letmegobacktosleep/8k_hall_effect_keypad/README.md

8 key hall effect pcb using STM32F072CBT6
- has not been tested
- requires [JLCPCB Tools](https://github.com/Bouni/kicad-jlcpcb-tools) plugin for exporting gerbers/bom/pos

untested firmware available at https://github.com/letmegobacktosleep/qmk_firmware/tree/minipad
