letmegobacktosleep/8k_hall_effect_keypad/8 key thingy.kicad_pcb

## KiCad design 8 key thingy.kicad_pcb (2024-04-30)

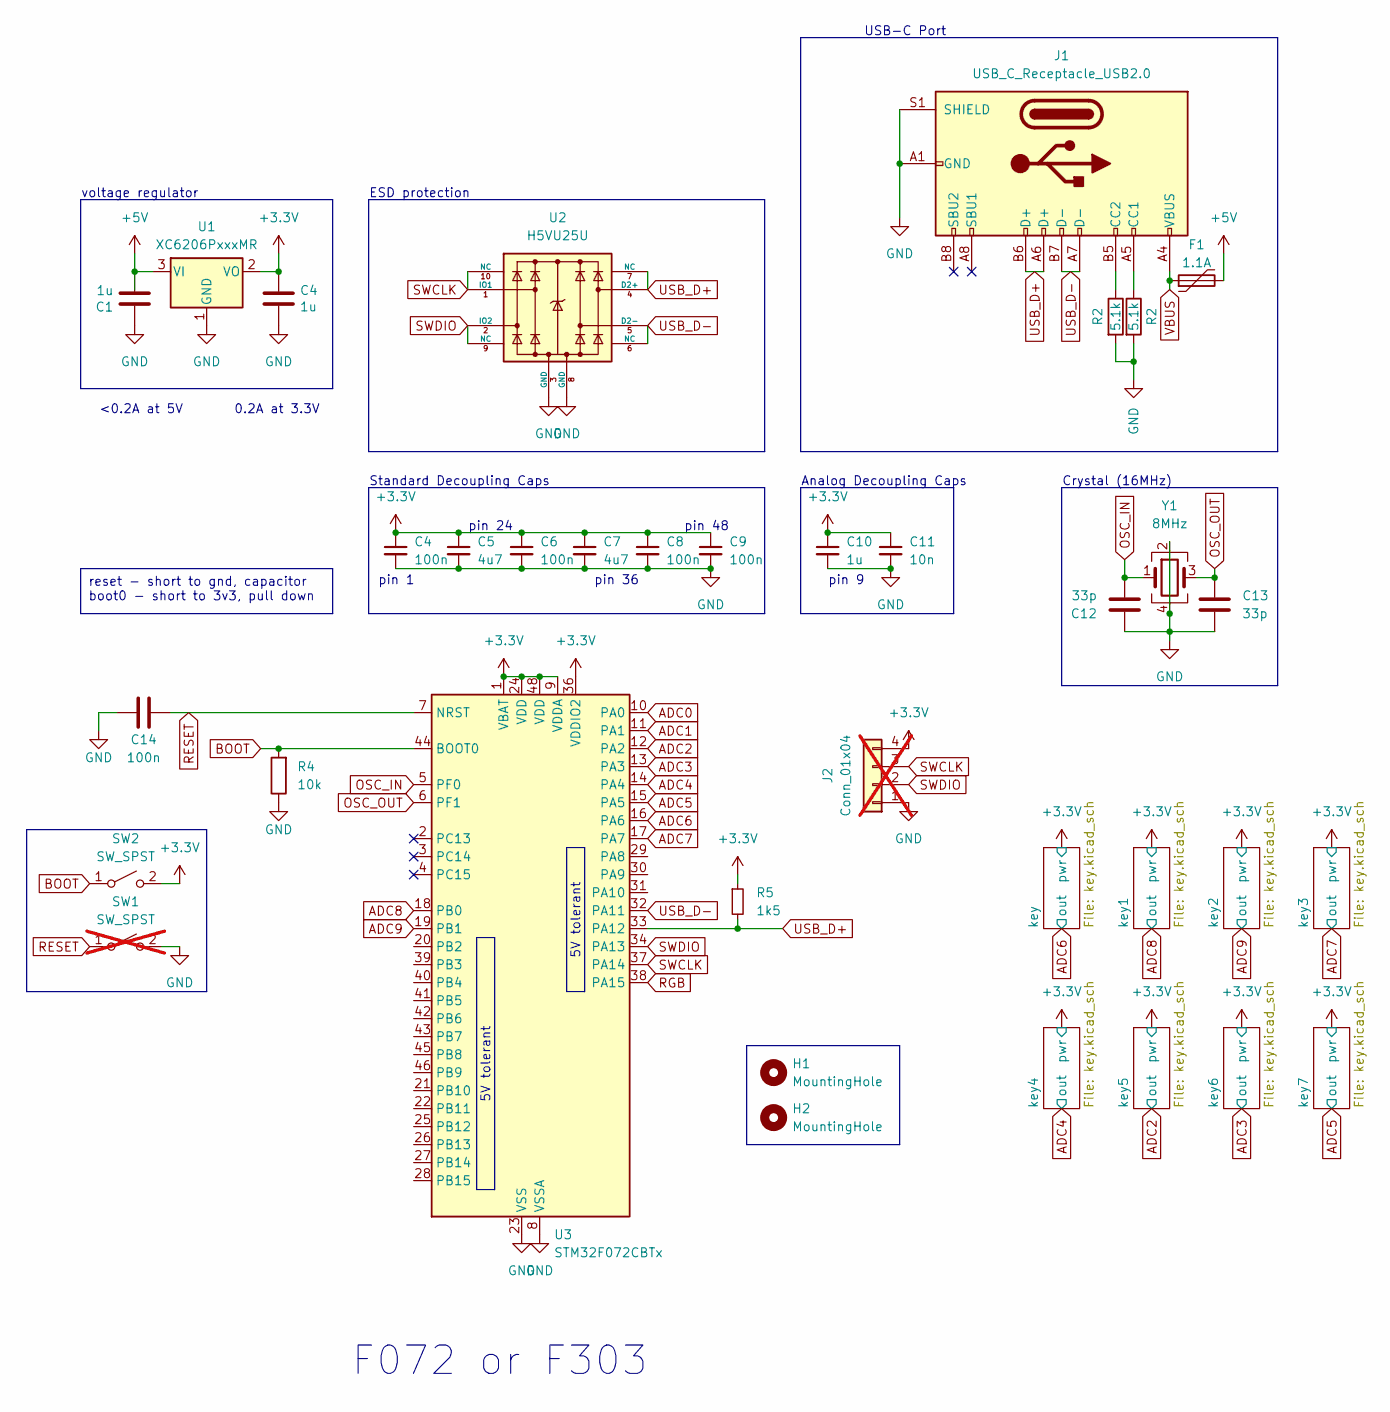
[picture p1: schematic 8 key thingy.kicad_sch]

Parts:
C1, C4: 1u; C_0805_2012Metric; LCSC C28323
C5, C7: 4u7; C_0402_1005Metric; LCSC C23733
C6, C8, C9, C14: 100n; C_0402_1005Metric; LCSC C1525
C10: 1u; C_0402_1005Metric; LCSC C52923
C11: 10n; C_0402_1005Metric; LCSC C15195
C12, C13: 33p; C_0402_1005Metric; LCSC C1562
F1: 1.1A; Fuse_1206_3216Metric; LCSC C2760273
H1, H2: MountingHole; MountingHole_3.2mm_M3
J1: USB_C_Receptacle_USB2.0; USB_C_Receptacle_HRO_TYPE-C-31-M-12 (marbastlib); LCSC C165948
J2: Conn_01x04; PinSocket_1x04_P2.54mm_Vertical; not fitted
R2: 5.1k; R_0402_1005Metric; LCSC C25905
R4: 10k; R_0402_1005Metric; LCSC C25744
R5: 1k5; R_0603_1608Metric; LCSC C22843
SW1: SW_SPST; SW_SPST_TL3342; LCSC C318884; not fitted
SW2: SW_SPST; SW_SPST_TL3342; LCSC C318884
U1: XC6206PxxxMR; SOT-23; LCSC C5446
U2: H5VU25U; DFN2510 (from moonboard); Manufacturer Part Number TPD4E05U06DQAR; LCSC Part Number C7420374
U3: STM32F072CBTx; LQFP-48_7x7mm_P0.5mm; LCSC C81720
Y1: 8MHz; Crystal_SMD_3225-4Pin_3.2x2.5mm; LCSC C2682774

Connections:
+3.3V: C4.1, C5.1, C6.1, C7.1, C8.1, C9.1, C10.1, C11.1, J2.4, R5.1, SW2.2 (B), U1.2 (VO), U3.1 (VBAT), U3.9 (VDDA), U3.24 (VDD), U3.36 (VDDIO2), U3.48 (VDD); also elsewhere on the board
+5V: F1.2, U1.3 (VI); also elsewhere on the board
ADC0: U3.10 (PA0)
ADC1: U3.11 (PA1)
ADC2: U3.12 (PA2); also elsewhere on the board
ADC3: U3.13 (PA3); also elsewhere on the board
ADC4: U3.14 (PA4); also elsewhere on the board
ADC5: U3.15 (PA5); also elsewhere on the board
ADC6: U3.16 (PA6); also elsewhere on the board
ADC7: U3.17 (PA7); also elsewhere on the board
ADC8: U3.18 (PB0); also elsewhere on the board
ADC9: U3.19 (PB1); also elsewhere on the board
BOOT: R4.2, SW2.1 (A), U3.44 (BOOT0)
GND: C4.2, C5.2, C6.2, C7.2, C8.2, C9.2, C10.2, C11.2, C12.1, C13.2, C14.2, J1.A1 (GND), J1.A12 (GND), J1.B1 (GND), J1.B12 (GND), J1.S1 (SHIELD), J2.1, R2.2, R4.1, U1.1 (GND), U2.3 (GND), U2.8 (GND), U3.8 (VSSA), U3.23 (VSS), U3.35 (VSS), U3.47 (VSS), Y1.2, Y1.4; also elsewhere on the board
OSC_IN: C12.2, U3.5 (PF0), Y1.1
OSC_OUT: C13.1, U3.6 (PF1), Y1.3
RESET: C14.1, SW1.1 (A), U1.7, U3.7 (NRST)
RGB: U3.38 (PA15)
SWCLK: J2.3, U2.1 (IO1), U2.10 (NC), U3.37 (PA14)
SWDIO: J2.2, U2.2 (IO2), U2.9 (NC), U3.34 (PA13)
USB_D+: J1.A6 (D+), J1.B6 (D+), R5.2, U2.4 (D2+), U2.7 (NC), U3.33 (PA12)
USB_D-: J1.A7 (D-), J1.B7 (D-), U2.5 (D2-), U2.6 (NC), U3.32 (PA11)
VBUS: F1.1, J1.A4 (VBUS), J1.A9 (VBUS), J1.B4 (VBUS), J1.B9 (VBUS)

Parts of its further copies:
C2, C3: 1u; C_0805_2012Metric; LCSC C28323
R3: 5.1k; R_0402_1005Metric; LCSC C25905

Connections of its further copies:
+3.3V: C3.1; also elsewhere on the board
+5V: C2.2; also elsewhere on the board
GND: C2.1, C3.2, R3.2; also elsewhere on the board

Notes on the sheet:
5V tolerant
reset - short to gnd, capacitor boot0 - short to 3v3, pull down
F072 or F303
Analog Decoupling Caps
pin 48
ESD protection
Standard Decoupling Caps
0.2A at 3.3V
USB-C Port
voltage regulator
pin 36
pin 24
Crystal (16MHz)
pin 9
<0.2A at 5V
pin 1

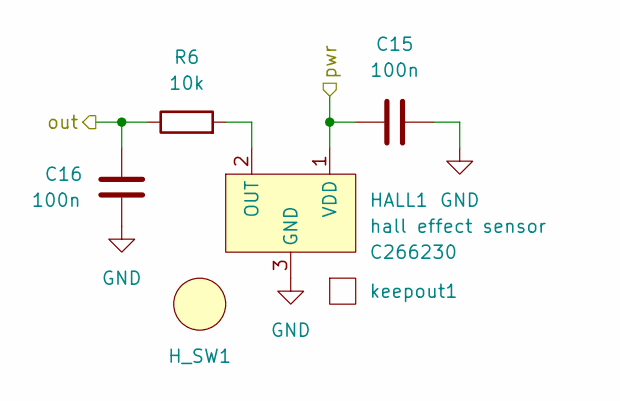
[picture p2: schematic key.kicad_sch]

Parts:
C15, C16: 100n; C_0402_1005Metric; LCSC C1525
HALL1: hall effect sensor; SOT-23; LCSC C266230
H_SW1: switch holes; LCSC holes
R6: 10k; R_0402_1005Metric; LCSC C25744
keepout1: copper_keepout

Connections:
+3.3V: C15.1, HALL1.1 (VDD); also elsewhere on the board
ADC6: C16.2, R6.1; also elsewhere on the board
GND: C15.2, C16.1, HALL1.3 (GND); also elsewhere on the board
unnamed: HALL1.2 (OUT), R6.2

Parts of its further copies:
C17, C18, C19, C20, C21, C22, C23, C24, C25, C26, C27, C28, C29, C30: 100n; C_0402_1005Metric; LCSC C1525
HALL2, HALL3, HALL4, HALL5, HALL6, HALL7, HALL8: hall effect sensor; SOT-23; LCSC C266230
H_SW2, H_SW3, H_SW4, H_SW5, H_SW6, H_SW7, H_SW8: switch holes; LCSC holes
R7, R8, R9, R10, R11, R12, R13: 10k; R_0402_1005Metric; LCSC C25744
keepout2, keepout3, keepout4, keepout5, keepout6, keepout7, keepout8: copper_keepout

Connections of its further copies:
+3.3V: C17.1, C19.1, C21.1, C23.1, C25.1, C27.1, C29.1, HALL2.1 (VDD), HALL3.1 (VDD), HALL4.1 (VDD), HALL5.1 (VDD), HALL6.1 (VDD), HALL7.1 (VDD), HALL8.1 (VDD); also elsewhere on the board
ADC2: C26.2, R11.1; also elsewhere on the board
ADC3: C28.2, R12.1; also elsewhere on the board
ADC4: C24.2, R10.1; also elsewhere on the board
ADC5: C30.2, R13.1; also elsewhere on the board
ADC7: C22.2, R9.1; also elsewhere on the board
ADC8: C18.2, R7.1; also elsewhere on the board
ADC9: C20.2, R8.1; also elsewhere on the board
GND: C17.2, C18.1, C19.2, C20.1, C21.2, C22.1, C23.2, C24.1, C25.2, C26.1, C27.2, C28.1, C29.2, C30.1, HALL2.3 (GND), HALL3.3 (GND), HALL4.3 (GND), HALL5.3 (GND), HALL6.3 (GND), HALL7.3 (GND), HALL8.3 (GND); also elsewhere on the board
unnamed: HALL2.2 (OUT), R7.2
unnamed: HALL3.2 (OUT), R8.2
unnamed: HALL4.2 (OUT), R9.2
unnamed: HALL5.2 (OUT), R10.2
unnamed: HALL6.2 (OUT), R11.2
unnamed: HALL7.2 (OUT), R12.2
unnamed: HALL8.2 (OUT), R13.2

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
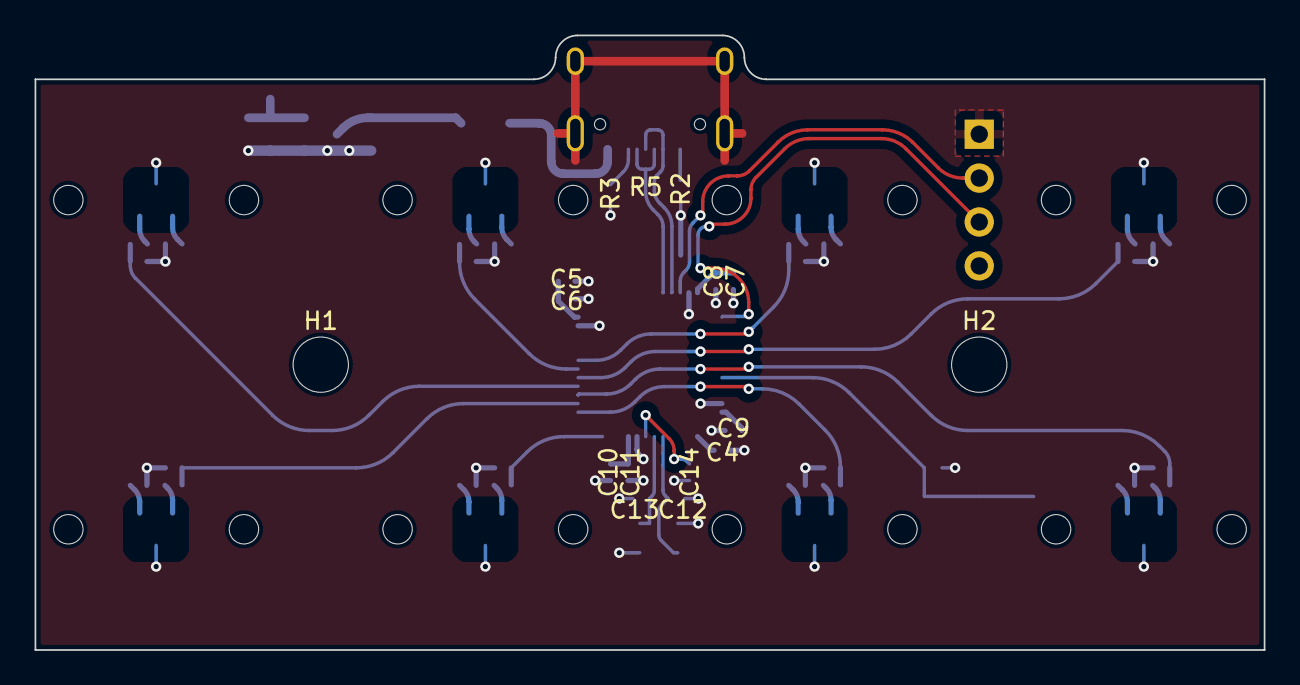
[picture p3: board 8 key thingy.kicad_pcb from above]

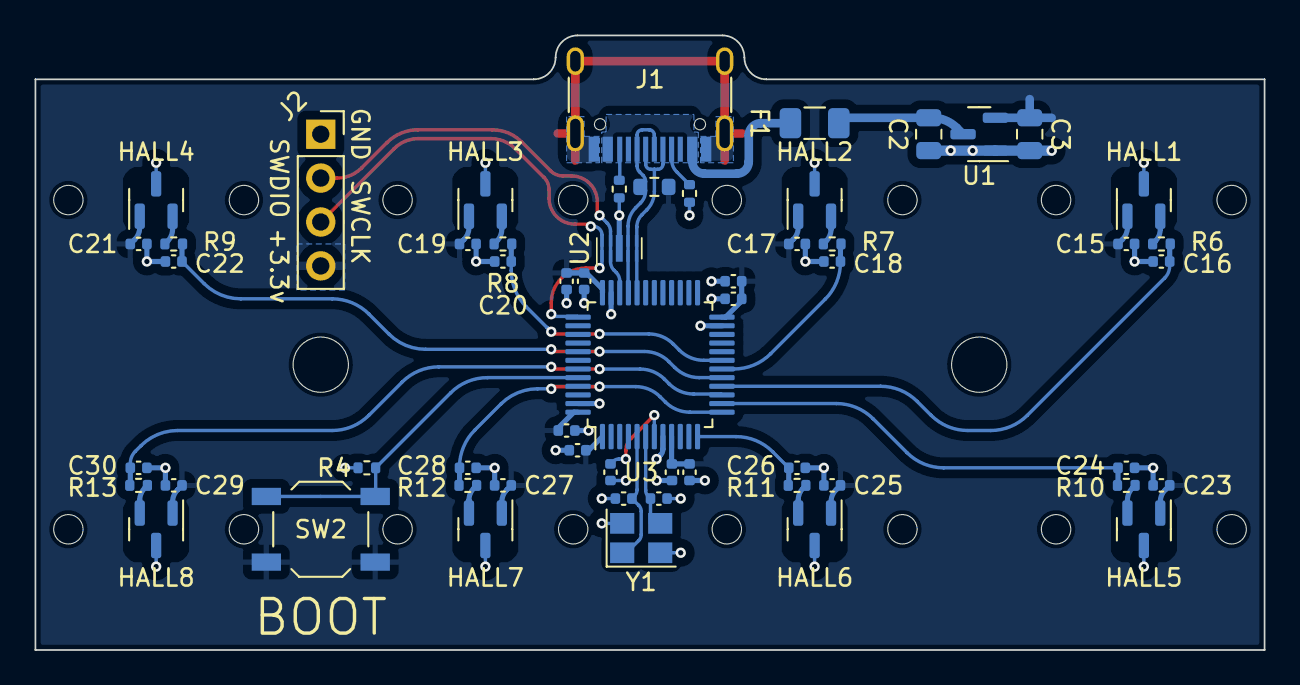
[picture p4: board 8 key thingy.kicad_pcb from below]

Board: 2 copper layers, 71.1 x 35.6 mm, 75 parts (65 on the bottom side), 30 nets.
